GlenNicholls/solar_tracking_project/docs/pi_hat/pi_pinout.JPG

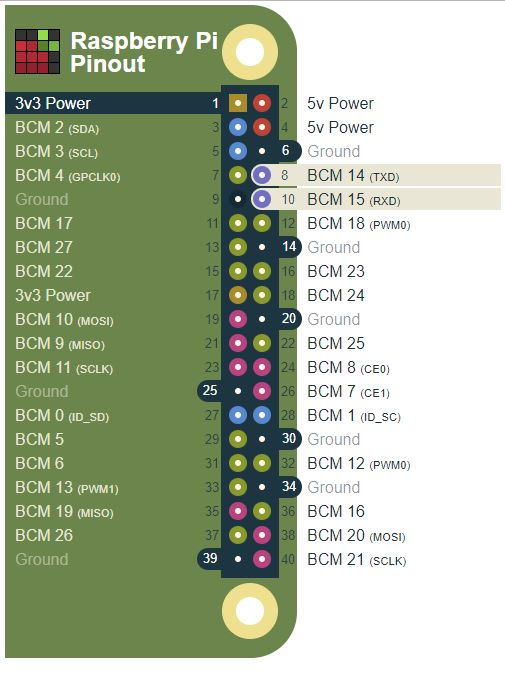
docs/pi_hat/pi_pinout.JPG
