GlenNicholls/solar_tracking_project/src/README.md

# TODO:
Update with descriptions of each package

* ACS712
* DS3231
* management_scripts
* MCP3008
* misc_dev
* motor_control
* open_loop_tracking
* shaft_encoder
* system_monitor
