GlenNicholls/solar_tracking_project/docs/pi_hat/GPIO_Pinout.xlsx

Component Pin | Description | Pi # | BCM # | Notes
Shaft Encoders
Az A | Azimuth A | 29 | 5 | lvl shifted
Az B | Azimuth B | 23 | 11 | lvl shifted
El A | Elevation A | 37 | 26 | lvl shifted
El B | Elevation B | 33 | 13 | lvl shifted
MCP3008 ADC
ADC 10 | CS | 19 | 10
ADC 11 | DIN | 38 | 20
ADC 12 | DOUT | 35 | 19
ADC 13 | CLK | 40 | 21
DS3231 RTC
RTC 7 | SDA | 3 | 2 | lvl shifted, DNP 3.3 lvl shift resistor
RTC 8 | SCL | 5 | 3 | lvl shifted, DNP 3.3 lvl shift resistor
ATTiny84 Microcontroller
AT 4 | RST_IN | 36 | 16 | lvl shifted, 5v from USB directly
AT 6 | PA7_PCINT7 | 22 | 25 | lvl shifted
AT 7 | MOSI | 18 | 24 | lvl shifted
AT 8 | MISO | 16 | 23 | lvl shifted
AT 9 | SCK | 32 | 12 | lvl shifted
AT 10 | PA3_DM | 24 | 8 | lvl shifted
AT 12 | PA1_FAULT | 26 | 7 | lvl shifted
L297 Motor Control
L297_1 | AZIMUTH_EN | 15 | 22 | enable for azimuth motor driver
L297_2 | ELEVATION_EN | 13 | 27 | enable for elevation motor driver
L297 | RESET_N | 31 | 6 | shared between both L297 driver chips
L297 | CLOCK_N | 21 | 9 | shared between both L297 driver chips
L297 | DIRECTION | 28 | 1 | shared between both L297 driver chips
Limit Switches
LIM_SW | 0 | 11 | 17
LIM_SW | 0 | 12 | 18
