GlenNicholls/solar_tracking_project/docs/sun_sensor/sun_sensor model.PNG

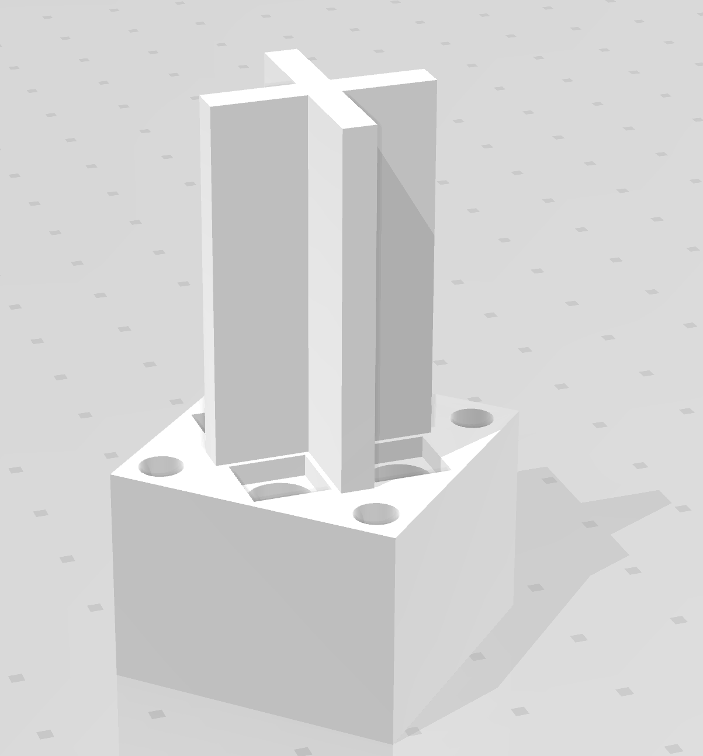
docs/sun_sensor/sun_sensor model.PNG
