GlenNicholls/solar_tracking_project/hardware/pi_hat/bom_2018_10_19T213238.xlsx

Index | Quantity | Part Number | Manufacturer Part Number | Description | Customer Reference | Available | Backorder | Unit Price | Extended Price USD
1 | 26 | 311-10.0KMCT-ND | RC0201FR-0710KL | RES SMD 10K OHM 1% 1/20W 0201 |  | 26 | 0 | 0.046 | 1.20
2 | 2 | 296-46095-1-ND | INA215AIDCKR | IC CURRENT MONITOR 1% SC70-6 |  | 2 | 0 | 1.5 | 3.00
3 | 2 | 1276-1013-1-ND | CL03A104KQ3NNNC | CAP CER 0.1UF 6.3V X5R 0201 |  | 2 | 0 | 0.1 | 0.20
4 | 13 | BSS138CT-ND | BSS138 | MOSFET N-CH 50V 220MA SOT-23 |  | 13 | 0 | 0.279 | 3.63
5 | 1 | 277-1238-ND | 1729034 | CONN TERM BLOCK 4POS 5MM PCB |  | 1 | 0 | 2.11 | 2.11
6 | 1 | 36-2998CT-ND | 2998TR | BATTERY RETAINER COIN 6.8MM SMD |  | 1 | 0 | 0.75 | 0.75
7 | 1 | P1.0NDCT-ND | ERJ-M1WTF1M0U | RES 0.001 OHM 1% 1W 2512 |  | 1 | 0 | 0.57 | 0.57
8 | 1 | CSRN2512FKR300CT-ND | CSRN2512FKR300 | RES 0.3 OHM 1% 2W 2512 |  | 1 | 0 | 0.73 | 0.73
