GlenNicholls/solar_tracking_project/docs/sun_sensor/final_v2.stl

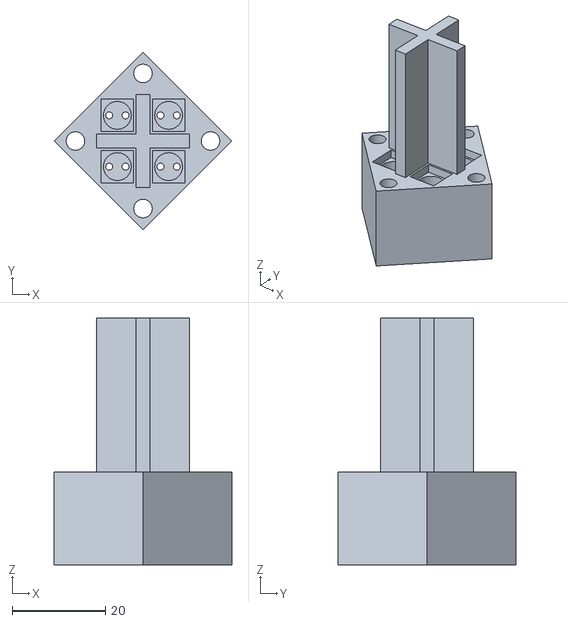
[picture p3: CAD file, 2018-12-11]
docs/sun_sensor/final_v2.stl
38.2 x 38.2 x 53.0
