GlenNicholls/solar_tracking_project/(list of files, cad)

Other CAD files:
docs/sun_sensor/final_v1.dwg
