GlenNicholls/solar_tracking_project/docs/changelog.txt

#REV, original part/connection, new part/connection, notes
