GlenNicholls/solar_tracking_project/(threads)

Thread 2 (2018-10-17):

Todo: WDT

bandtank, 2018-10-17:
https://github.com/GlenNicholls/solar_tracking_project/blob/bb61a96dae439378dc81f3529e3258df7cf112c5/misc_dev/attiny84a/src/ex_blinky_interrupts/ex_blinky_interrupts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

Setup and enable the WDT. Use a timer match/overflow interrupt/compare to reset the WDT. This is critical in case you get into a weird state.

Thread 4 (2018-10-17):

Multiple interrupts causing contention

bandtank, 2018-10-17:
https://github.com/GlenNicholls/solar_tracking_project/blob/89bd5b87050819dc284a78d5802128b977265ed5/misc_dev/attiny84a/src/power_circuit_ctrl/power_circuit_ctrl/mai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

How will multiple interrupts cause contention? This comment makes me think the right way to handle servicing the power control lines is to do it in a function outside of an interrupt. Setting flags and making a decision later will prevent contention issues if you don't have all the information in one ISR.

GlenNicholls, 2018-10-17:
That was an old comment that I don't think applies. I think the most complicated scenario is that the RTC alarm state interrupt is currently expected to change while the pi hold on interrupt is being serviced. I think this should change as it doesn't feel like the right way of doing it. As for contention, I've just been reading the value of the PORTA register to make sure it's being changed only when it needs to be.

bandtank, 2018-10-17:
We can talk through the logic to decide how to handle the actual setting and clearing of the bit. There are a number of ways to do it, most of which involve either an explicit or implicit mutex. Implicit mutexing can be accomplished by abstraction of error and/or boundary checking in functions.

Thread 5 (2018-10-17):

Unnecessary interrupt flag clearing

bandtank, 2018-10-17:
https://github.com/GlenNicholls/solar_tracking_project/blob/89bd5b87050819dc284a78d5802128b977265ed5/misc_dev/attiny84a/src/power_circuit_ctrl/power_circuit_ctrl/mai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

https://github.com/GlenNicholls/solar_tracking_project/blob/89bd5b87050819dc284a78d5802128b977265ed5/misc_dev/attiny84a/src/power_circuit_ctrl/power_circuit_ctrl/mai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

https://github.com/GlenNicholls/solar_tracking_project/blob/89bd5b87050819dc284a78d5802128b977265ed5/misc_dev/attiny84a/src/power_circuit_ctrl/power_circuit_ctrl/mai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

Being explicit is never bad, but this isn't necessary to do because the flags are cleared automatically when the ISR executes. Unless you have a specific reason to clear the flag at the end of the ISR, such as masking a new interrupt request for the same ISR while it's already being serviced, I would let it clear the flag on its own. There are rare, yet subtle, consequences to doing things like this that may not always be obvious up front.

GlenNicholls, 2018-10-18:
Just removed these for the time being. Will add later if we run into a situation where we need it.

Closed 2018-10-18.

Thread 6 (2018-10-17):

Software debounce

bandtank, 2018-10-17:
https://github.com/GlenNicholls/solar_tracking_project/blob/89bd5b87050819dc284a78d5802128b977265ed5/misc_dev/attiny84a/src/power_circuit_ctrl/power_circuit_ctrl/mai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

Implementing a software debounce using a timer will be relatively simple and usually quite robust. I'm guessing you didn't literally mean sleep, but, just to be sure, don't use sleep. The ISR will sit there twiddling it's thumbs which is bad news. ISRs need to get in and get out ASAP.

GlenNicholls, 2018-10-18:
So when using a timer, I assume it should just be started in the ISR, then the processor goes back to sleep and wakes up again when the timer raises a software interrupt?

GlenNicholls, 2018-10-18:
Oh nevermind, I see there is a timer interrupt vector.

bandtank, 2018-10-18:
You can start and stop timers wherever you want. Timers may be one of, if not the most, useful peripherals. It would behoove you to study the timer chapters in depth because the counting patterns, waveforms, match generation interrupts, and tons of other things have practically unlimited applications. I once made a state machine that used four timers, each with four compare match interrupts, to drive an external DAC and then the input capture source of a fifth timer to get nanosecond precision on a timing pulse. I've seen much crazier things from other designers as well.

Tiny's don't have a ton of features, but the timers are still powerful. Once you get a handle on things, come back to timers to keep the system asleep as long as possible in as many situations as possible. You can double up on compare match interrupts for multiple high-level functions by keeping track of rollovers and things like that in globals or static variables.

Thread 7 (2018-10-17):

Readability and maintainability enhancements

bandtank, 2018-10-17:
https://github.com/GlenNicholls/solar_tracking_project/blob/89bd5b87050819dc284a78d5802128b977265ed5/misc_dev/attiny84a/src/power_circuit_ctrl/power_circuit_ctrl/mai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

In general, doing things like that can be prone to bugs later. It's also quite difficult to change pin assignments if you decide to make layout modifications. Do something like this:

    #define POWER_ON_PIN  PA0
    #define POWER_ON_PORT PORTA
    #define TURN_POWER_ON  SET_BIT(POWER_ON_PORT, POWER_ON_PIN)
    #define TURN_POWER_OFF CLR_BIT(POWER_ON_PORT, POWER_ON_PIN)

That is much, _much_ easier to maintain and it's also a lot more clear while reading the code what is happening. It also protects against logic inversions, e.g. if the power pin is active low instead of active high. Turning it on is very clear whereas literally setting or clearing a bit may not be.

GlenNicholls, 2018-10-18:
Is it best practice to place all of these in a header file?

bandtank, 2018-10-18:
That’s a bit of a religious question depending on who you ask. In general, yes, this type of thing should be in a header file because the code shouldn’t have any idea about the physical manifestation of the algorithm. Turn the power on means turn the power on regardless of how that translates into hardware. It’s not always that concise obviously, but abstraction is your friend especially when it comes to hardware interfaces.

Typically, I create header files with the following things from top to bottom:
* include statements
* hardware specific preprocessor definitions
* macros like LED0_ON, etc.
* function prototypes

In more complex projects, I will often put hardware specific definitions in a separate file to keep things organized and obvious. It depends on a lot of things, so there’s no right answer; be consistent and clear regardless.

While I’m thinking about it, embedded applications have to be smart about using strings more than you may currently realize. When you printf a fixed string, for example, it stores the string on the stack or heap depending on the situation, but you can’t afford to to support either option.

The flash memory is in a different address space depending on the architecture and accessing it from an instruction may or may not be possible. If it is possible like in an Atmel microcontroller, you can store strings there at the cost of significantly increased access time. On small microcontrollers, avoid this entirely by not using strings at all. When I say strings, I mean `char *` just to be clear.

In terms of memory conservation, globals and general purpose registers can be quite useful as long as you understand the volatile keyword and all that it implies. People get their parties in a bunch about globals on any platform, but they’re fine even in high level languages as long as you use them properly. Anyway, embedded applications are different due to memory constraints, so the paradigm isn’t as taboo.

Thread 12 (2018-10-21):

Put this in a package with sunrise/sunset similar to other packages

GlenNicholls, 2018-10-21:
https://github.com/GlenNicholls/solar_tracking_project/blob/c96660d3944b09754b287629c967a6d3fd50009d/src/main.py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

GlenNicholls, 2018-10-25:
Have new issue that captures this and a couple other things better...

Closed 2018-10-25.

Thread 15 (2018-10-21):

Last step should be making sure we can actually shutdown

GlenNicholls, 2018-10-21:
https://github.com/GlenNicholls/solar_tracking_project/blob/c96660d3944b09754b287629c967a6d3fd50009d/src/main.py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

We don't want to stomp on user in development mode noted by uC pin. There should be a routine here that doesn't set the next alarm until the user is done. Might need some smarts as well to see if we missed the next wakeup period as we're screwed if we right an alarm to the RTC and the time has passed already.

Maybe this might be bug at some point, but we'll burn that bridge when it falls.

GlenNicholls, 2018-11-08:
The following code needs to be tested

https://github.com/GlenNicholls/solar_tracking_project/blob/abf6216847b46e178da2fa546de0279f9cbe5690/src/main.py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

Thread 18 (2018-10-21):

Consider using built-in macros for AVR register access

bandtank, 2018-10-21:
https://www.nongnu.org/avr-libc/user-manual/group__avr__sfr.html

```
#define _BV(bit)   (1 << (bit))
#define bit_is_set(sfr, bit)   (_SFR_BYTE(sfr) & _BV(bit))
#define bit_is_clear(sfr, bit)   (!(_SFR_BYTE(sfr) & _BV(bit)))
#define loop_until_bit_is_set(sfr, bit)   do { } while (bit_is_clear(sfr, bit))
#define loop_until_bit_is_clear(sfr, bit)   do { } while (bit_is_set(sfr, bit))
```

It could simplify some of the defines, but it's fine either way.

GlenNicholls, 2018-10-21:
interesting, I'll check this out! I knew there was something like this, but the examples I saw online looked like they were for Arduino IDE, so I wasn't sure where those were coming from.

bandtank, 2018-10-21:
On that note, check the [library reference](https://www.nongnu.org/avr-libc/user-manual/modules.html). There's a ton of stuff you might need, e.g. [Power Reduction Management](https://www.nongnu.org/avr-libc/user-manual/group__avr__power.html). There's value in learning how to do these things manually, but using library functions doesn't completely mask the requirement to understand what you're doing with the hardware.

GlenNicholls, 2018-10-22:
If I have to learn how to use a library, I quit.

bandtank, 2018-10-22:
Let’s go collect sand so we can make our own silicon wafers. I think we should start all the way at the beginning to make sure we do as much non-innovative work as possible.

GlenNicholls, 2018-10-22:
Ooo, that's a good idea. Another thing I thought would be a good idea for system configuration, we should use a CSV with sub-delimeters to load our settings

GlenNicholls, 2018-10-25:
Used many of these noted in the macro libraries.

Closed 2018-10-25.

Thread 19 (2018-10-24):

Define clocking for uC in Makefile

GlenNicholls, 2018-10-24:
https://github.com/GlenNicholls/solar_tracking_project/blob/5e9910b60f4fe3ec53cd6ad5541e268fe9e95c2b/misc_dev/attiny84a/src/pi_hat_ctrl/Makefile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

Best to define clocking here and pass it down to the code... Spent a long time trying to talk to this device again after reducing the clock to 125kHz and the default programming speed couldn't identify the device or recover fuses.

-i is the spi clock delay, so this should also be parameterized according to system clock. Should be ~4 times slower than the uC system clock

bandtank, 2018-10-24:
You might want to go slower than 4x. That should be fine, but slower won't hurt anything.

Is the delay in microseconds? You should probably put a comment specifying the unit and how it is used to derive the clock frequency. It will also be very helpful down the road if you put a comment in the makefile about how to program the microcontroller using the file. It's fresh in your mind now, but it won't be in six months (hypothetically).

GlenNicholls, 2018-10-24:
Yes, it is in us. I'll put a comment in there to denote both of those things. What is a reasonable frequency to run at? I am currently using 125kHz, but I feel like I could divide the clock all the way and be fine, I'm just not sure if there is going to be something that will bite me later.

bandtank, 2018-10-24:
Which clock do you intend to use as the system clock and at which frequency? As far as I know, this system doesn’t have much processing to do and there are relatively lax deadlines involved; assuming that’s true, I think the low power, internal 128 KHz oscillator would be sufficient. You may even be able to use a prescaler of 8 to provide a system clock of 16 KHz if the system can tolerate that setting.

In the first case, I would use a 25 KHz programming frequency. In the second case, 4 KHz would be appropriate. 25% is a good rule of thumb and should always work, but there’s no reason to rush it since this will be done very infrequently, if ever, after it works reliably.

Debug is different. For now, go faster so you aren’t waiting forever to iterate.

GlenNicholls, 2018-10-29:
documenting your email suggestion so I don't forget to do this:

    make -DF_CPU=125000

somewhere in the code:

    #ifndef F_CPU
    #error You must define F_CPU
    #else
     #if F_CPU == 125000
       OCRA1 = 0x12;
     #elif F_CPU == 250000
       OCRA1 = 0x34;
     #else
       #error Unsupported value for F_CPU
     #endif
    #endif

GlenNicholls, 2018-10-30:
From suggestion, this has been tested and works well. The worst case programming SCK has been accounted for to be 4x slower than the lowest device frequency:

https://github.com/GlenNicholls/solar_tracking_project/blob/64621bb102d3db1e32168b8d61db00277a282412/misc_dev/attiny84a/src/pi_hat_ctrl/Makefile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

The below is used to configure each timer along with clocking:

https://github.com/GlenNicholls/solar_tracking_project/blob/64621bb102d3db1e32168b8d61db00277a282412/misc_dev/attiny84a/src/pi_hat_ctrl/attiny84.h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

Closed 2018-10-30.

Thread 20 (2018-10-25):

[PCB] Programming uC will cut power to pi

GlenNicholls, 2018-10-25:
When the pi starts to program eeprom by pulling reset low, all the pins enter their default state causing the load switch to turn off. This will mean the pi will be shutoff as soon as it starts to program. If this is just a floating pin, we can add an external pullup. If not, I think the best solution is to add a jumper for programming mode where the load switch is pulled up and the pi doesn't lose power when programming. Will investigate this further this weekend.

GlenNicholls, 2018-10-25:
If there is a way to make pins use pullups during reset, I will do that instead.

bandtank, 2018-10-25:
No. You will have to use an external component to guarantee the state of a pin that isn't actively driven by the microcontroller. During reset, the pins configured as floating inputs and, as far as I know, there's no way to alter that behavior.

GlenNicholls, 2018-10-25:
Darn, wish I thought of this before we did the PCB. I'll just blue-wire something for the time being and we'll update the schematic to use a jumper.

GlenNicholls, 2018-10-25:
So open the issue against the layout and reference in the notes of the schematic?

GlenNicholls, 2018-10-25:
Also, I just tested this and it looks like the load switch isn't affected. The output remains high for anything other than a logic zero. I'm not sure if it's worth looking into further in this case, but I'm open to suggestions. I guess if the load switch ever gets changed this might be an issue, but as of now, it looks like it is not affected during ICSP.

GlenNicholls, 2018-10-25:
So the datasheet says that it cannot be left floating and doesn't say anything about an internal pullup. I think putting an external pullup on that line makes the most sense unless you would prefer we use a jumper. I'm going to use a pullup for our PCB so we don't have to re-spin it, but we can put a jumper in the schematic/layout we give you.

bandtank, 2018-10-25:
I presumed it would not have an internal pullup, so you'll need to add one. This is a bug waiting to happen.

There's nothing wrong with cutting traces, adding components, or using jumpers to modify the board. It's uncommon to get it right on the first try and correct behavior is far more important than a pristine layout.

GlenNicholls, 2018-10-26:
I see your point. Closed testing at home at room temperature with no switching is fine. I suspect that higher temperatures and noise will cause this to fail.

bandtank, 2018-10-26:
Yeah, that's pretty much the idea. Temperature, noise, stray capacitance, solar activity, and many other things could cause non-deterministic behavior.

GlenNicholls, 2018-10-31:
@graemeDnf, feel free to close this when the pcb reflects ISSUE#20 in the schematic

Closed 2018-11-03.

Thread 21 (2018-10-25):

How accurate is this?

GlenNicholls, 2018-10-25:
https://github.com/GlenNicholls/solar_tracking_project/blob/5e9910b60f4fe3ec53cd6ad5541e268fe9e95c2b/src/main.py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

Need to figure out how accurate this is. If this is pulling location from nearest ISP whatever it's called, this could be pretty far away from customers location.

I messed with something similar (not with python) a long time ago and it was yielding lat/long of Comcast in Colorado Springs about 5 miles from my house. I don't know how this error would affect us if this is the case, but it's worth looking in to. If this is the case and it is too much error, we could have something in the high-level interface for the user to enter their specific coordinates.

bandtank, 2018-10-25:
There's nothing wrong with requiring input from the user to setup a system like this. Getting the location automatically is a nice feature, but I wouldn't bother with it. It's too small of a feature and it will cost too much time to validate the process. Ask for lat/long and call it a day.

GlenNicholls, 2018-11-19:
Just checked this and it is indeed very far off due to info above. A better solution might be http://www.indjango.com/google-api-to-get-lat-long-data/ but this is not a priority at all. I will be hardcoding for now unless we have time to do this

Thread 23 (2018-10-29):

[PCB] Switching noise from alarm condition causes uC to briefly enter reset due to TTL threshold

GlenNicholls, 2018-10-29:
RESET_N pin of uC has been having issues when the alarm pin goes low causing device to briefly enter reset which causes glitching on power control pin (led to false positive during testing). Need to add 10K pullup to fix the metastable condition.

Probing without the pullup, the voltage is 1.54V (3.3V Vcc), but drops to 1.48V during an alarm condition before slowly coming back up to 1.54V where it comes out of reset. Probing the RESET_N pin caused this brief reset not to occur, so I think that capacitance caused the device not to drop below the TTL threshold.

bandtank, 2018-10-29:
The reset pin definitely needs to be pulled high. You should also add a
capacitor to ground.

On Sun, Oct 28, 2018 at 7:04 PM GlenNicholls <notifications@github.com>
wrote:

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

GlenNicholls, 2018-10-29:
We have this going through a level shifter, should the LPF be on the high or low side? Does it matter?

bandtank, 2018-10-29:
Is the schematic updated? If so, where should I be looking?

GlenNicholls, 2018-10-31:
@graemeDnf , feel free to close this when the PCB has the pullup noted by ISSUE#23 in the schematic.

Closed 2018-11-01.

Thread 24 (2018-10-29):

Missed voltage divider resistors on PCB

GlenNicholls, 2018-10-29:
ISSUE#24 is noted in PDF for the missing resistors from the PCB.

graemeDnf, 2018-10-30:
Added resistor dividers for voltage measurement

Closed 2018-10-30.

Thread 25 (2018-10-30):

[UCSW] Sleep mode for attiny84a does not work per noted code

GlenNicholls, 2018-10-30:
After referencing a few sources in addition to the following, the below sleep code still does come out of sleep from interrupts:

[https://www.electronicsweekly.com/blogs/engineer-in-wonderland/atduino-go-sleep-attiny-2017-08/](url)

https://github.com/GlenNicholls/solar_tracking_project/blob/dc396e505067940ffb68f793bffcb7f520a1185a/misc_dev/attiny84a/src/pi_hat_ctrl/main.c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

bandtank, 2018-10-30:
Have you tried it without any of the more complex logic? What happens if you simply go to sleep in main using `sleep_cpu()`? Have you ever successfully woken the uc from sleep in any configuration?

GlenNicholls, 2018-10-30:
Sorry for the confusion, I just tested that with just the IDLE sleep mode and the device successfully comes out of that. When I test with power down, I'm unable to get it to come out of sleep with an alarm condition on the RTC which will turn power on based on INT0

bandtank, 2018-10-30:
Make sure you are following the constraints in this paragraph:

```
7.1.3 Power-Down Mode
When the SM[1:0] bits are written to 10, the SLEEP instruction makes the MCU enter Powerdown
mode. In this mode, the Oscillator is stopped, while the external interrupts, and the Watchdog
continue operating (if enabled). Only an External Reset, a Watchdog Reset, a Brown-out
Reset, an external level interrupt on INT0, or a pin change interrupt can wake up the MCU. This
sleep mode halts all generated clocks, allowing operation of asynchronous modules only.
```

GlenNicholls, 2018-10-30:
So I was trying to debug why it wasn't working so I continue to re-enable the interrupts as I wasn't sure if there was something that wasn't stated explicitly in the datasheet (the ads on the site made it impossible to see what that person's reasoning was). After removing that code, I see the same behavior.

Once I added a 50ms delay, I was able to get the push button to get the device out of power down, so after removing the delay, it looked like it would sometimes catch the button interrupt, and sometimes it wouldn't (due to the 8-bit timer clock going down beforehand). However, the `INT0` interrupt was never recognized with this delay. After I used a pin change interrupt, `PCINT10` on `PCINT1_vect`, I am able to capture all interrupts, so it does look like the `cli();` caused the processor to catch the interrupt, but not set it in time before disabling interrupts.

Looks like the issue was with there not being enough delay before `cli();`, but I think that at 32kHz, the `INT0` level is not held long enough with the 50ms delay.

I think this is resolved, but this brings up a question again that I asked you a while ago about putting numerous pin change interrupts on one INT vector. Will this have any implications moving forward that I am not aware of?

GlenNicholls, 2018-10-31:
This has been tested and will now be closed.

Closed 2018-10-31.

Thread 26 (2018-10-30):

Will cause py.test to hang

GlenNicholls, 2018-10-30:
With a `while true:`, this will cause test to hang when py.test constructs the test fixture. Consider referencing `DS3231/test` for creating a test function/class and change to `dev_*.py` for development checks to run manually. This should have a test, but using the filename `test_*.py`, py.test will add this to the sources when it does an os walk.

https://github.com/GlenNicholls/solar_tracking_project/blob/54261cbb0eadff70b82e4030e92d69b88a0ffb34/src/shaft_encoder/test/test_class_counting.py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

GlenNicholls, 2018-11-08:
name has been changed and test routine needs to be added

Thread 27 (2018-10-30):

[PCB] Update silkscreen and ensure component numbers match schematic

GlenNicholls, 2018-10-30:
Silkscreen needs to be updated and all component numbers should match schematic. For the headers, make sure that the silkscreen states what each pin is for.

For each component, make sure the component number is not covered by the part and readable with surrounding traces. Also ensure no vias or surrounding pads will cut off the number. For some of the passive components, the pads cut off part or all of the number/letter.

For the pi header, note with slikscreen which pin is pin1, I assume it's the square one, but this should be done to be safe. With this said, dots for ICs in the component outline should be used instead of the line that is hard to see on the PCB.

For all diodes and LEDs, there should be an arrow to note the continuity. I will add comments as I find other stuff.

GlenNicholls, 2018-11-08:
@graemeDnf I know I texted you about this, but you said this has been updated?

Closed 2018-11-19.

Thread 29 (2018-10-30):

[PCB] Add ground plane to reduce noise and interference

GlenNicholls, 2018-10-30:
A ground plane should be on the list of todos to be completed eventually. Probably best to have a digital ground plane as well, but we can always use some 1-10ohm resistor for the ADC with just an analog ground plane.

Thread 30 (2018-10-30):

[PCB] Break out motor control pins to header

GlenNicholls, 2018-10-30:
Motor control pins should be broken out to external header similar to the shaft encoders so we don't need to use extra long headers on the Pi to use these.

GlenNicholls, 2018-11-08:
@graemeDnf What is the status of this?

Thread 31 (2018-10-30):

[PCB] Add test points

GlenNicholls, 2018-10-30:
Add test points for important nets. I will be adding comments for where some of these should go for the stuff that I did

GlenNicholls, 2018-11-04:
* pin 3, 6 of DS3231
* pin 3, 4, 6-10, 12, 13 of attiny
* +5v/Gnd of USB
* pin 5||8 of tps22958
* pin 9-16 of MCP3008

Closed 2018-11-19.

Thread 32 (2018-10-30):

[PCB] Add motor control PCB and documentation to hardware/

GlenNicholls, 2018-10-30:
The motor control PCB layout, schematic, and documentation need to be added to the project soon.

Thread 33 (2018-10-30):

[PCB] fix missing connection on attiny devmode level shifter

graemeDnf, 2018-10-30:
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
Connection was deleted between low side of level shifter and 3.3v rail

graemeDnf, 2018-10-30:
PCB file updated and pushed, awaiting confirmation of bluewire fix on existing board

GlenNicholls, 2018-10-30:
yeah that's gonna be a bit if you want to CALM DOWN

GlenNicholls, 2018-10-30:
Just to confirm, the highlighted via connects to the left pad of the resistor right above it?

graemeDnf, 2018-10-30:
Correct. This is the bottom copper though, so the directions will be flipped when you look at the bottom side of the actual board. Also, it will probably be easiest to solder that resistor pad to the left pad of one of the neighboring resistors (same net) rather than the via

Thread 34 (2018-10-30):

[SCH] R33/35 DNP was mistakenly swapped with R34/36

GlenNicholls, 2018-10-30:
on the pi-hat schematic, R33/35 should not be DNP, but R34/36 should be instead. R34/36 resistors are on the low side on the pi and should be DNP so we don't have to de-solder resistors on SDA/SCL on the pi.

Closed 2018-11-29.

Thread 35 (2018-10-30):

[SCH] R23 states 250mOhm, but BOM has 300mOhm

GlenNicholls, 2018-10-30:
In the schematic, R23 for the current sensor is shown to be 250mOhm, but the BOM has a 300mOhm on order. Probably not a big deal, but should be accounted for in calculations and should also be adjusted to whichever is the correct value.

graemeDnf, 2018-10-30:
300m was significantly cheaper in the 2512 package, so I put that on the BOM. I ensured it would work with the new value, so I'll update it when I get a chance

GlenNicholls, 2018-10-30:
okay cool, I just wanted to make sure.

Closed 2018-11-19.

Thread 36 (2018-10-30):

[PCB] S2 should be on edge of board

GlenNicholls, 2018-10-30:
S2 is a right angle push button and should be on the edge of the PCB

GlenNicholls, 2018-11-02:
vertical push button can work as well, but doesn't matter a whole lot

GlenNicholls, 2018-11-08:
@graemeDnf What is the status of this or adding vertical push button?

Thread 37 (2018-10-30):

[PCB] Switch connection error (Graeme messed up, mk2)

graemeDnf, 2018-10-30:
attiny pin wired to incorrect side of pushbutton switch

GlenNicholls, 2018-10-30:
Can you be more specific with a pic? I'm not seeing the issue unless it's the via, but I don't know where that goes.

GlenNicholls, 2018-10-31:
Also, remove R37, R6, and C5 from the PCB as these aren't needed since debouncing in software works more than well enough. Just let me know where I should connect the wires for the button instead and I'll test it on Thursday.

Closed 2018-11-01.

Thread 38 (2018-10-31):

[PCB] LEDs have wrong pad size: 1206 instead of 0603

GlenNicholls, 2018-10-31:
The pad size of the LEDs looks like 1206, but should be 0603

Closed 2018-11-01.

Thread 46 (2018-10-31):

[PISW] Add Makefile or automatic system configuration

GlenNicholls, 2018-10-31:
Use a Makefile or something similar to automatically configure the system using the steps in the README. In addition to the README steps, this should also run the main.py application and add this to the boot sequence so it runs automatically on power up.

GlenNicholls, 2019-01-30:
Found this which will make this fairly easy:

https://www.raspberrypi.org/forums/viewtopic.php?f=63&t=226609

Thread 47 (2018-10-31):

[SCH,PCB] Add changelog.txt

GlenNicholls, 2018-10-31:
Add changelog to keep track of changes to PCB and schematic

GlenNicholls, 2018-11-01:
Closing per 162d92a and 062ac8

Closed 2018-11-01.

Thread 49 (2018-10-31):

[PISW] Change ACS712 package to support INA215

GlenNicholls, 2018-10-31:
This class should be abstracted further since we have a different current sensor. The eqns are probably in the datasheet. As for other devices using the MCP3008 ADC, we need to pull that out of this class and possibly pass in an ADC instantiation instead.

GlenNicholls, 2018-11-08:
Done per b07c53d

Closed 2018-11-08.

Thread 50 (2018-11-01):

[PCB] Incorrect reference connection on curr. sense amps

graemeDnf, 2018-11-01:
ref (pin 1) should be connected to ground rather than +3.3v on both shunt resistor amplifiers

GlenNicholls, 2018-11-01:
I have added a changelog, so just fill this out as stuff gets updated in the schematic/pcb

Closed 2018-11-01.

Thread 51 (2018-11-01):

[PCB] Push button wiring error

graemeDnf, 2018-11-01:
attiny pin is connected to gorund, rather than floating voltage pin of the pb switch

Closed 2018-11-19.

Thread 52 (2018-11-01):

[PCB] Add issue numbers to track these bugs/enhancements

GlenNicholls, 2018-11-01:
Can you add the issue numbers for each of these?

https://github.com/GlenNicholls/solar_tracking_project/blob/a8d980774f226571aa13784ffcb01d792a122243/hardware/pi_hat/changelog.txt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

Thread 53 (2018-11-02):

[PISW] Figure out how to enable debug log level for specific sub-module

GlenNicholls, 2018-11-02:
This would be a nice feature where the user could select from the high-level interface which sub-module to spit out to file/database without having to spew a ridiculous amount of unwanted information from other modules.

https://github.com/GlenNicholls/solar_tracking_project/blob/ff0ca15a51329c8713c68a152ccea38717c1dcd2/src/main.py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

GlenNicholls, 2018-11-09:
Researched this a bit and it isn't too bad:

https://stackoverflow.com/questions/7234262/how-to-implement-different-levels-for-specific-modules-in-python

Currently, I have something like the following:

    class some_class(object):
        def __init__( logger='main_logger')
            self.logger = logging.getLogger(logger + '.' + __name__)

This will yield a call that shows `main_logger.<class dir>.some_class`. However, this method does not lend itself to easily vary the debug level for this specific module based on the above link. To adjust this, we can hardcode the names in the top level with the following example code

>>>main.py:

    logger_name = 'main_app'
    sub_1_name = 'sub_module'

    inst = some_class(logger_name, sub_1_name)

This will yield the following output name somewhere in the log `main_app.sub_module`, then we can easily use the above link to have a higher level interface select to turn on debug level logging for this module. The class should now look like this:

    class some_class(object):
        def __init__( logger='main_logger', module_name='module_name')
            self.logger = logging.getLogger(logger + '.' + module_name)

This example can be seen in the `power_measurement.py` package, I will also start adding this compatability.

GlenNicholls, 2018-11-12:
closed per 29b9c7f

Closed 2018-11-12.

Thread 54 (2018-11-02):

[UCSW] Add manual clearing of FAULT

GlenNicholls, 2018-11-02:
Currently, the device cannot clear fault condition unless re-flashed. Will be adding a manual override for this using the push button where the SW will set a flag and start the big timer and if the button is still held, it will clear the fault flag.

I can't immediately think of a situation where this is needed, but might be nice to have if the bug has been fixed on the pi side without having to re-flash software.

GlenNicholls, 2018-11-12:
closed per 06944a0

Closed 2018-11-12.

Thread 55 (2018-11-02):

[PISW] Pass objects by reference to keep main clean

GlenNicholls, 2018-11-02:
Specifically for power measurements and the shaft encoder interrupts, instantiate object in main and pass to sub-classes by reference.

Closed 2018-11-13.

Thread 56 (2018-11-02):

[PCB] remove pcb files that are out of date

GlenNicholls, 2018-11-02:
Not sure if that file is needed, but I don't want to cause issues by removing it

Closed 2018-11-29.

Thread 57 (2018-11-02):

[PCB] USB micro B female not close enough to edge of board and needs revision

GlenNicholls, 2018-11-02:
The usb connector needs to be closer to the edge of the PCB. The silkscreen box edge for the USB connector should be touching the edge of the PCB.

Also, we need something with pins that go down into the PCB as the force to plug it in will rip the connector off the board.

graemeDnf, 2018-11-03:
Moved header to the edge of the board. Did you solder the larger pads on the header to the board as well? it seems like the pin breakout boards still have a usb header mounted on the surface in the same way, so I'm not sure if using something like that will make a difference

GlenNicholls, 2018-11-03:
@graemeDnf I thought I did, I watched the solder flow under the scope, but it doesn't look like it made a good connection since I don't have an oven or a heat gun... I guess I wasn't careful enough. The two smaller pads were definitely connected, but the two big ones looked pretty clean after the break. With that said, having something with pins that go into the board will give more support for external forces. I looked around online, and this seems to be a really common issue with the type of connector that we chose unless you're conscious about plugging USB in.

Considering we're pulling straight from the charge controller USB, we don't have many other options, but I think it will work fine if we can solder a couple pins in a via.

If you look at the pi, it has something like this and seems to work pretty well. Now that I think about it, we should definitely change to a button that has a vertical push as well so we don't run into this again with that.

GlenNicholls, 2018-11-04:
We need something similar to this:

https://www.mouser.com/ProductDetail/Hirose-Connector/ZX62D-B-5PA830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

GlenNicholls, 2018-11-04:
Also, if it is possible, try to extend the 5 pin pads for the power/data lines to make soldering the device easier

graemeDnf, 2018-11-04:
Ended up using this https://www.digikey.com/product-detail/en/amphenol-fci/10118194-0001LF/609-4618-1-ND/2785382. I tried making a PCB symbol with extended pads, but couldn't get designspark to play nice with the necessary spacing tolerance, so I went with the amphenol connector because it had a pcb footprint available

Closed 2018-11-04.

Thread 58 (2018-11-04):

[PCB] Break out power to header

GlenNicholls, 2018-11-04:
Put in a debug power header somewhere so I can connect a power supply if needed.

GlenNicholls, 2018-11-08:
Done per 5f4a625

Closed 2018-11-08.

Thread 59 (2018-11-04):

[PCB] Remove diode D4

GlenNicholls, 2018-11-04:
This needs to be removed and replaced with a wire

graemeDnf, 2018-11-04:
done

Closed 2018-11-04.

Thread 62 (2018-11-05):

[PISW] Make flash gui

GlenNicholls, 2018-11-05:
Tony, can you make us a flash gui and couple it as tight as possible to our application code?

bandtank, 2018-11-05:
Holy shit. I saw 'Make flash gui' on my phone's notification and I almost had a heart attack. Funny, yet cruel.

Closing with prejudice.

GlenNicholls, 2018-11-05:
good, I had a feeling this would induce a similar response.

Closed 2018-11-05.

Thread 63 (2018-11-06):

[PISW] Abstract pin definitions to top level

GlenNicholls, 2018-11-06:
This should be abstracted and defined in the top level to make debugging easier if GPIO selections ever change.

https://github.com/GlenNicholls/solar_tracking_project/blob/5f4a6251b6567d04bb99f3fe21d7501a97bfdef9/src/motor_control/stepper_motor.py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

GlenNicholls, 2018-11-13:
done

Closed 2018-11-13.

Thread 64 (2018-11-06):

[PISW] Avoid using python keywords for variables

GlenNicholls, 2018-11-06:
https://github.com/GlenNicholls/solar_tracking_project/blob/5f4a6251b6567d04bb99f3fe21d7501a97bfdef9/src/motor_control/stepper_motor.py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

Thread 66 (2018-11-07):

[PCB] Consider INA219 if we can't get INA215 working properly

GlenNicholls, 2018-11-07:
Not too sure why the INA215 is not working properly, but my suspicion is that we got the wrong part. Nothing in the PCB looks off and I have bluewired the correct GND reference and still see the same behavior. With the way the INA is placed, I am seeing Vout reading 3.2V on both sensors, so either our calculation for the shunt resistor is wrong, or the ongoing issues with the chip markings indicate that the part sent is not correct.

I have found this: https://www.adafruit.com/product/904

Let's wait to look into this further until the re-spin gets here. I will be looking into the current sensors further to see if I can figure out what is going on with this thing.

GlenNicholls, 2018-11-09:
While testing each ADC channel, this is what I see:

    | ADC Ch 0 | ADC Ch 1 | ADC Ch 2 | ADC Ch 3 | ADC Ch 4 | ADC Ch 5 | ADC Ch 6 | ADC Ch 7 |
    +----------+----------+----------+----------+----------+----------+----------+----------+
    |   927    |   925    |    57    |    14    |    7     |    6     |    4     |    0     |
    +----------+----------+----------+----------+----------+----------+----------+----------+
    |   927    |   925    |    32    |    5     |    1     |    2     |    8     |    10    |
    +----------+----------+----------+----------+----------+----------+----------+----------+
    |   926    |   925    |    23    |    8     |    7     |    5     |    0     |    1     |
    +----------+----------+----------+----------+----------+----------+----------+----------+
    |   926    |   925    |    26    |    3     |    2     |    3     |    10    |    9     |
    +----------+----------+----------+----------+----------+----------+----------+----------+

First two channels are the current sensor outputs where maximum is 1024. I am seeing identical results when I probe these channels. I do not think that we have this connected wrong, but I think our selections for the Rshunt is not correct. I haven't had much luck finding anything specific to the INA, but per the white paper I read, the value according to ON is `I_sens = (Vout/Gain)/Rshunt`

https://www.allaboutcircuits.com/industry-white-papers/fundamentals-of-current-sense-amplifiers/pdfdownload/

With this equation, I am not surprised that channel 0 is over ranging (3.3v/75/0.3ohm=`0.1467A`). Channel 1 is curious to me, though, since I have the resistors grounded and see 3.23V output when I shouldn't (3.3v/75/0.001ohm=`44A`)

The TI website says that I should see ~15% error in the low current range for the 1mohm sensor, but this is much greater than that.... Let's test this thing on friday with a stable source and see if these change at all. If not, I have absolutely no clue how to debug any further. When I talked with digi-key, the rep made it sound like the pin assignments are supposed to be mirrored from the way the datasheet shows, so I am looking around for dev boards online to see if this is visible. If this is the case, this is going to be a PITA to fix.

GlenNicholls, 2018-11-17:
OMG TI!!!!!! Bout to post some chat from digi-key about their lack of updating ina21x documentation... BE PREPARED!!!!

GlenNicholls, 2018-11-17:
So, in short, the bar goes up. I have tried this with no success. I will try again with a stable current source on Sunday. I will be re-orienting the part, so if this doesn't work, I will try a new part. If it still doesn't work, I am throwing in the towel.

_**Info: Thank you for choosing to chat with us.  An agent will be with you shortly.
Info: You are now chatting with Chris_ext_2813.
Chris_ext_2813: Welcome to Digi-Key Live-Help. How may I assist you?
Glen: Hello, I am working with the INA215 and am unable to get consistent results. I have reached out before due to the lack of markings on the device for determining where pin 1 is and still am unable to get ADC raw readings that make any sense
Glen: The device is not marked with a dot on the top or bottom indicating where pin 1 is, but instead marked with "|SME"
Chris_ext_2813: Really? There is supposed to be a pin 1 index area on the top of the chip. Let me see if I can find anything on it.
Glen: I talked with a Timothy in a previous chat, although I didn't save the chat. Anyways, can I forward you an email that has the pic of the device under the scope? And you are correct, there is no marking for pin 1. I purchased 8 of these devices on our first order and was unable to get it working. A colleague then ordered two more from a seperate batch, and they have identical markings and perform the exact same
Chris_ext_2813: Yes you can send photos to datacenter@digikey.com

Just put ATTN: Chris x2813 in the subject line.

The SME marking is correct so we just have to try to figure out why there is no pin 1 mark on it.
Glen: Okay, I have just sent the email. For reference, I have configured the layout for unidirectional current sensing per page 15 in http://www.ti.com/lit/ds/symlink/ina210.pdf
Glen: I have tried the device in the orientation I sent you as well as rotated 180degrees. I have verified our ADC works, and for the orientation in the email, I see 0 no matter what, and with the shift, the ADC is close to railing at 3.24V with a vref of 3.3V. For reference, I am using the INA213, not INA215, so I apologize for that
Glen: My interpretation per the datasheet's top view is that the pin 1 is where the white line is in the scope picture and incrementing in a standard counter-clockwise fashion...
Chris_ext_2813: Well that would be my thought as well, but all their documents seem to show they use a standard dot to mark pin 1 and I see no PCNs from TI about any marking change on it so it seems odd. I just now got your email. Let me take a look
Glen: No worries, I'm not frustrated or anything. I'm just confused since it is a pretty straight-forward design and I have not had issues like this in the past with current shunt amplifiers
Chris_ext_2813: So I would expect it to have a dot according to the spec sheet which it does not have. The SME mark is correct and the two hashes above and below the marking is the date code marking. Looking at it, I would expect pin 1 to be the lower left pin and then the pins go up counter clockwise. One would assume the line is specifying the pin 1 side which would make the lower left pin 1.
Glen: Is it possible for you to use the snipping tool to label how you believe the pins are on the device in the picture that I sent? I'm not sure I understand exactly
Chris_ext_2813: Ok. So I did find a post on Texas Instruments E2E forum where someone had the same issue on a different part number and TI did confirm that the end with the bar is the pin 1 end. So pin 1 would be the lower left corner in your picture.

Let me see what I can do to label the pins in your photo.
Chris_ext_2813: Ok. I just sent you an email with labels for the pins. We do not have much for software on our work computers, but I think it is fairly legible.
Glen: Alright, thank you. I'm just waiting on the email now. Are you able to send me the link to the E2E forums you were mentioning earlier?
Chris_ext_2813: I did not put it in the email and like I said, the post is on a different part, but it the same issue. Data sheet just shows a shaded area in the corner labeled "Pin 1 Index Area", but the part received just had a bar down one side.

http://e2e.ti.com/support/audio/f/6/t/46746?which-is-pin-1-on-TPA6101A2-
Glen: Interesting, thank you for that reference. One final question before I part: The picture that you just sent, that is with respect to the markings on the part, correct?
Chris_ext_2813: Well I really just went off the fact they state the bar indicates pin 1. Because of how the parts are pinned, pin 1 has to be in the lower left corner and then I just labeled them according to the pin out on the data sheet.

But in general, pin 1 would be in the lower left corner with the marking correctly oriented to read it. While that is almost always how they are pinned, I did not want to say it was definitively the same until I found something from TI to confirm it.
Glen: I see, so from the picture that I sent, you would also agree that I had it oriented correctly considering the white bar indicating pin 1 on the PCB?
Chris_ext_2813: Yes I would agree
Glen: I'm just having trouble determining your point of reference since the datasheet shows pin 1 in the upper right hand corner. Thank you for working with me through the confusing explanations of pin numbering (it's easy when manufacturers mark their parts :/)
Glen: upper left hand*
Chris_ext_2813: It does, but it also has the IC turned 90°. If you flipped the picture 90°, pin 1 would then be in the upper left like the drawing on page 5
Chris_ext_2813: But I feel confident those pins are labeled correctly in the photo I sent
Glen: yeah, page 5 is the reference I was using. Okay perfect, I think that is the confirmation that I needed. Is there a way to pass along a complaint to TI about not mentioning the bar in their datasheet? Their pictures showed a standard dot marking which is what I expected to see, so it was definitely a process trying to decode this
Chris_ext_2813: You will actually notice on the E2E link that the customer they dealt with then said the same thing and it does not look like they have done anything to correct it yet and that post was from 8 years ago.

I am guessing TI is just not very concerned about it as they have done nothing to correct it still. I can certainly pass it along though.
Glen: haha yep, I just saw that. Well, here's to hoping! I would definitely appreciate that and I have now learned my lesson! I think I have what I need, so thank you again for taking the time to work with me.
Chris_ext_2813: Happy to help you. I hope it works correctly for you now.
Glen: yeah, I now have other things to debug it looks like considering I tried that orientation. I will reach out to them directly if I can't figure out what is going on
Chris_ext_2813: That is certainly a good option. That e2e forum generally gets you answers in a fairly timely manner. Although I do not know if anyone monitors it on weekends so you may be waiting until next week.

But if you still have issues come next week you can try contacting us again. The product managers work the banker hours Mon-Fri so they would be here 8-5 central time. Someone during the day may be able to help as well.
Chris_ext_2813: Is there anything else I can do for you today Glen?
Glen: I don't think so, I think that covers it!
Chris_ext_2813: Ok. Well good luck Glen and have a great weekend!
Glen: Same to you Chris!
Chris_ext_2813: Thank you for choosing Digi-Key. Feel free to contact us at any time.**_

GlenNicholls, 2018-11-19:
officially changed this to bug now that it is definitely not something we're doing wrong. I will be contacting TI to figure out what is going on with their part and looking around for another manufacturer that hopefully has something in the same package/pins. There will be no more debugging unless TI's response shows that the required bluewiring is realistic with everything else on the board populated...

GlenNicholls, 2018-11-30:
Looks like the issue boils down to needing INA 213 REVISION B! Closing this now that we have the sensors working reliably.

GlenNicholls, 2018-12-05:
Forgot to post this before:

https://e2e.ti.com/support/amplifiers/f/14/p/637442/2351816?tisearch=e2e-sitesearch&keymatch=tida-00302

Closed 2018-11-30.

Thread 67 (2018-11-09):

[PISW] Divide by zero is possible in sun sensor logic

GlenNicholls, 2018-11-09:
Per the below code, a divide by zero is occurring. To fix this bug, I have added a check. However, this should be calculated a different way so that a divide by zero isn't possible.

https://github.com/GlenNicholls/solar_tracking_project/blob/6af2f535bf763df34f412e42b67108aaeb416f1e/src/sun_sensor/sun_sensor.py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

example output shows how common this is while these ADC pins are floating:

    | Avg Horizon [%]  | Avg Vertical [%] |
    +------------------+------------------+
    |  0.133333333333  |  0.571428571429  |
    2018-11-08 17:28:02,430 - main_logger.sun_sensor - WARNING - Divide by zero occuring. Returning zero
    +------------------+------------------+
    | -0.229102167183  |       1.0        |
    +------------------+------------------+
    |  0.233333333333  |  0.823529411765  |
    2018-11-08 17:28:02,830 - main_logger.sun_sensor - WARNING - Divide by zero occuring. Returning zero
    +------------------+------------------+
    | -0.346749226006  |  0.933333333333  |
    +------------------+------------------+
    |       -0.1       |  -1.33333333333  |
    2018-11-08 17:28:03,263 - main_logger.sun_sensor - WARNING - Divide by zero occuring. Returning zero

GlenNicholls, 2018-11-09:
For more info, this might be able to be calculated as `% = num1/num2 * 100` and use an if statement to always divide by the bigger number. Even when ADC pins aren't floating, it should be very very unlikely to see either number as 0.

GlenNicholls, 2018-11-19:
Finalized this by moving to using a raw adc difference and averaging over a number of samples. We are no longer using percent differences since there is no gain and it is just unneeded complexity

Closed 2018-11-19.

Thread 68 (2018-11-11):

[PISW] Consider using GPIO.BOARD for pin numbering

GlenNicholls, 2018-11-11:
Using BCM is fine, but this could change between revisions of the raspberry pi. To fix this, consider using GPIO.BOARD as this will use the board pin numbering that will always be the same from pi revisions. Not really important right now, but something to consider working through for everything including AVRDude and MCP3008 package.

https://github.com/GlenNicholls/solar_tracking_project/blob/ca2fcb39cc0256b9cda4ceb9b5df7ddbd9b800b5/runner/main.py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

Thread 69 (2018-11-16):

[PCB] Dev mode and FAULT pins of the attiny never go low due to level shifter

GlenNicholls, 2018-11-16:
due to the resistor on the high-side of the level shifter, both LED 1 & 5 do not turn off as there is a pullup on this net. After probing the low-side, these both always read 3.3V and the high-side reads 2.75V when the pin is driven low. Is it valid to remove these two resistors??

GlenNicholls, 2018-11-16:
Another weird thing I notice is when I press and hold the button, both LEDs mentioned turn off completely, but the status LEDs for the load switch are unaffected.

bandtank, 2018-11-16:
LEDs on these nets likely won't work long term. I didn't think about it before, but you'll probably need to drive the LEDs with another pin. You could also use comparators to drive the LEDs after calculating the expected voltages on either side of the level shifters, but that's a lot of work for no real gain. You can't pull any of the resistors out or the level shifter will stop working.

GlenNicholls, 2018-11-17:
Hmmm, good to know, I guess it is a good thing this isn't critical, although it will be annoying for the user. Is there a way to make this work with the level shifters?

bandtank, 2018-11-17:
I gave it some thought for a minute or two this morning and I didn’t come up with an obvious solution. Part of the problem is speed. If the net needs to be fast, it would be a bad idea to drive an LED without a buffer in series. There may be a more elegant solution, but using a comparator would work. You’d need to know the voltage levels in every condition: driving high and low from one side and then the other. At that point, pick a side and set the reference.

GlenNicholls, 2018-11-19:
we do have two free pins on the tiny, so I think that is the cleanest solution. @graemeDnf once the PCB is updated, feel free to close this

bandtank, 2018-11-19:
I typically put LEDs on a shift register. Even if you don’t want to use SPI, you can clock a shift register manually to get 8+ LEDs with only two pins. Just an idea.

Get Outlook for iOS<https://aka.ms/o0ukef>

________________________________
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

graemeDnf, 2018-11-29:
Moved relevant LEDs from level shifter lines to free GPIO pins (BCM 0 and BCM15)

Closed 2018-11-29.

Thread 70 (2018-11-16):

[PCB] LED 2 silkscreen shows wrong orientation

GlenNicholls, 2018-11-16:
LED2 orientation in the slikscreen is backward, the dot should be facing the other direction.

graemeDnf, 2018-11-29:
fixed

Closed 2018-11-29.

Thread 71 (2018-11-16):

[PISW] ADC object not callable in runner/main.py

GlenNicholls, 2018-11-16:
When instantiating the adc in main.py like so:

https://github.com/GlenNicholls/solar_tracking_project/blob/a6b06f27422e76f25a4b74cffd05f2398193b8c8/runner/main.py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

https://github.com/GlenNicholls/solar_tracking_project/blob/a6b06f27422e76f25a4b74cffd05f2398193b8c8/runner/main.py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

It only fails here:

https://github.com/GlenNicholls/solar_tracking_project/blob/a6b06f27422e76f25a4b74cffd05f2398193b8c8/runner/main.py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

but works fine for the previous instantiation:

https://github.com/GlenNicholls/solar_tracking_project/blob/a6b06f27422e76f25a4b74cffd05f2398193b8c8/runner/main.py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

https://github.com/GlenNicholls/solar_tracking_project/blob/a6b06f27422e76f25a4b74cffd05f2398193b8c8/runner/main.py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

This is the log:

    pi@raspberry:~/solar_tracking_project $ sudo python runner/main.py
    2018-11-15 20:34:00,636 - main_app.rtc - INFO - creating an instance of the rtc
    2018-11-15 20:34:00,639 - main_app.sys_mon - INFO - creating an instance of the sys_mon
    <Adafruit_MCP3008.MCP3008.MCP3008 object at 0xb5c0db30>
    2018-11-15 20:34:00,651 - main_app.panel_power - INFO - creating an instance of the panel_power
    2018-11-15 20:34:00,656 - main_app.battery_power - INFO - creating an instance of the battery_power
    Traceback (most recent call last):
      File "runner/main.py", line 166, in <module>
        adc_object             = adc
    TypeError: 'module' object is not callable

I have dug around a bit and after checking this in the sun_sensor package, I do not see the same issues.

GlenNicholls, 2018-11-16:
fixed per  77ba9a3

Closed 2018-11-16.

Thread 72 (2018-11-16):

[PCB] Add missing connections for motor control

GlenNicholls, 2018-11-16:
Missing motor control connections for the PCB need to be added to the CSV following the format that I have defined.

https://github.com/GlenNicholls/solar_tracking_project/blob/414cd067f740381de8ed945e593da0e2582edce6/runner/gpio.csv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

Thread 74 (2018-11-16):

[PISW] Add dataframe class

GlenNicholls, 2018-11-16:
Per our discussion today, work on a class for setting up a dataframe. Reference .runner/ for main.py where it will live, .test/ for dataframe tests, and .src/ for where all application packages live.

Columns that would be needed:
* time
* latitude/longitude
* azimuth/elevation initial count value
* panel and battery voltage, current, power, energy?

Will add others as I think of them

GlenNicholls, 2018-11-26:
Closing per  2031667

Closed 2018-11-26.

Thread 78 (2018-11-19):

[PISW] Add limit switch INTs to halt motors in stepper motor class

GlenNicholls, 2018-11-19:
Adding pins like so:

https://github.com/GlenNicholls/solar_tracking_project/blob/8eca18658b97e4545bd6755c86a6eb138e5fe64d/src/motor_control/stepper_motor.py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

configure these as interrupts and ensure they immediately halt motors during an event. The motors should then move in the opposite direction some fixed amount to determine start position

GlenNicholls, 2018-11-29:
closed per most recent commit

Closed 2018-11-29.

Thread 79 (2018-11-19):

[SYS] Pi date and time do not update automatically on school network

GlenNicholls, 2018-11-19:
The date and time on the pi have not been updating automatically like they should, but I have only tested this on the school network. At home, I have not experienced this, but I also haven't been using VNC to develop on the device. Hopefully, this is unique to the school network so we don't have to figure out how to get the time since trying to use raspi-config didn't work and we had to set the time manually.

GlenNicholls, 2018-11-30:
ad43eab

Closed 2018-11-30.

Thread 80 (2018-11-19):

[PISW] Add lock error checking in open loop tracking mode

GlenNicholls, 2018-11-19:
In below function, add error checking for lock logic on both az/el. Should also add a counter so we don't get stuck here. On failure, an error should be logged with some extra information.

https://github.com/GlenNicholls/solar_tracking_project/blob/64155a29d0000d75d8f84c92314c2505538193bb/runner/main.py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

GlenNicholls, 2018-11-19:
We also need to figure out how to integrate the limit switch logic somewhere in here as well. I'm not too sure how this should work with the encoders yet, but there are a few cases I want to discuss:
* when encoder reads min/max count on either az/el
* if encoder thresh has not been met when limit switch is asserted

GlenNicholls, 2018-11-20:
closed per 2c058d3

Closed 2018-11-20.

Thread 83 (2018-11-29):

[PISW] Add user error for sim menu

GlenNicholls, 2018-11-29:
Add a way to induce user desired error in the simulation tracking menu to further demonstrate the shaft encoders.

GlenNicholls, 2018-12-08:
This isn't useful beyond demonstration and maybe during test. I am closing this for now.

Closed 2018-12-08.

Thread 85 (2018-11-29):

[PISW] Add error checking for calibration so system doesn't get stuck when motors don't move

GlenNicholls, 2018-11-29:
Currently, if the motors don't move, the system gets stuck in an infinite loop. Add some error checking so it doesn't get stuck and log the critical error for the user

Thread 86 (2018-11-29):

[PISW] Add limits to how much sun sensor can adjust system

GlenNicholls, 2018-11-29:
For cloudy days and such, the sun sensors should not be able to move the mount further than some amount so it doesn't go completely off course if there is a bright spot somewhere else in the sky. The shaft encoders will fix this, but POWER!!!

GlenNicholls, 2018-12-03:
It has been proven that the shaft encoders do fix this, but only on the next update cycle.

Closed 2018-12-05.

Thread 87 (2018-11-30):

[PCB] Move pi hat USB header so lip of physical hardware is over the edge of the board

GlenNicholls, 2018-11-30:
As the title states, this needs to be moved closer to the edge so the lip of the USB header is hanging off the edge of the board. Currently, the lip elevates the connector slightly. Maybe not a priority, but marking this bug so we don't lose track of the issue for the "customer".

Thread 88 (2018-11-30):

[PISW] Add support for full RTC timekeeping

GlenNicholls, 2018-11-30:
I have done the research, and it is possible to handle timekeeping of the pi using dtoverlay so that we do not need to have internet access all the time (thus the class for system parameters like wifi). There needs to be careful consideration with who has control. If we try to access RTC via I2C manually while the system has control with dtoverlay, there could be issues (I don't know what those are). However, we can set this control up via this question on the pi forums:

https://www.raspberrypi.org/forums/viewtopic.php?t=224235

I don't think I will have time to carefully implement this control, but it is documented here now as an enhancement... YOU'RE WELCOME TONY

Thread 92 (2018-11-30):

[SYS] Add config steps to README

GlenNicholls, 2018-11-30:
Add steps from following to README.

https://raspberrypi.stackexchange.com/questions/73166/raspberry-pi-zero-w-cant-connect-to-wifi-through-desktop-environment

I don't remember having to do this the first time, but the SD card I had to use from Mike didn't have the newest OS on it nor did it have access to internet to update.

GlenNicholls, 2018-11-30:
Not an issue with new raspbian OS

Thread 93 (2018-11-30):

[PISW] Test fails when doing fresh OS install with all software

GlenNicholls, 2018-11-30:
I am seeing this error when I try to run the test. i did a fresh os install and installed all software per the README

    pi@raspberrypi:~/solar_tracking_project $ sudo python setup.py test
    running pytest
    running egg_info
    writing requirements to src/pv_array_solar_tracker.egg-info/requires.txt
    writing src/pv_array_solar_tracker.egg-info/PKG-INFO
    writing top-level names to src/pv_array_solar_tracker.egg-info/top_level.txt
    writing dependency_links to src/pv_array_solar_tracker.egg-info/dependency_links.txt
    reading manifest file 'src/pv_array_solar_tracker.egg-info/SOURCES.txt'
    writing manifest file 'src/pv_array_solar_tracker.egg-info/SOURCES.txt'
    running build_ext
    Traceback (most recent call last):
      File "setup.py", line 64, in <module>
        package_data      = {'':['__init__.py']} # ['' : ['*.data', '*.rst'],] -- include packages with these file
    delimeters in all sub dirs from package_dir
      File "/usr/lib/python2.7/distutils/core.py", line 151, in setup
        dist.run_commands()
      File "/usr/lib/python2.7/distutils/dist.py", line 953, in run_commands
        self.run_command(cmd)
      File "/usr/lib/python2.7/distutils/dist.py", line 972, in run_command
        cmd_obj.run()
      File "build/bdist.linux-armv6l/egg/ptr.py", line 176, in run
      File "build/bdist.linux-armv6l/egg/ptr.py", line 187, in run_tests
      File "/usr/lib/python2.7/dist-packages/pytest.py", line 21, in <module>
        from _pytest.config import (
    ImportError: cannot import name _preloadplugins

Thread 94 (2018-11-30):

[PCB] Make unique connectors for all external interfaces...

GlenNicholls, 2018-11-30:
Based on today's short "incident", I am making a bug about the headers that we have currently. First, lets move that ground connection away from the high voltage connections... Next, I think it is a good idea to make sure all the headers for Mike's board and panel/battery can only be plugged into a specific header one way. In hindsight, we should've known better, but you live and you learn 👎

Thread 95 (2018-12-01):

ADC ch 2 curr. amp has intermittent gnd

graemeDnf, 2018-12-01:
The amplifier feeding into ADC channel 2 seems to have a spotty ground connection. It should be bluewired to the ground bus
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

GlenNicholls, 2018-12-03:
I discussed this with Mike and we decided that this isn't critical for us to fix right now. I am not going to be fixing this so that I can focus on other outstanding tasks for our pres, sw flow charts, etc.

graemeDnf, 2018-12-03:
I see how it is. My issues aren't important to you . . .

bandtank, 2018-12-03:
No matter what Glen says, you're important to me, Graeme.

GlenNicholls, 2018-12-05:
ditto

Thread 97 (2018-12-05):

[PISW] Limit sw ints cause mount to overshoot if it misses edge of next interrupt

GlenNicholls, 2018-12-05:

Closed 2018-12-05.

Thread 99 (2018-12-05):

[PISW] Bug in next position calculation for open loop menu

GlenNicholls, 2018-12-05:
The calculation for the next position below is incorrect. Update this to provide system with correct calculation for how far to move motors. In the lab, this update is incorrect and causes the motor to move to correct position and then immediately move back the difference.

https://github.com/GlenNicholls/solar_tracking_project/blob/4b9a3cfcd25955af6ff08a980abac3c126868e61/runner/main.py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

GlenNicholls, 2018-12-07:
I believe this "bug" was the initial indicator for #102. After fixing the calibration logic issue, I have tested this menu and I am not seeing the same issue where the mount moves the wrong direction when starting from the initial position after startup calibration.

The reason this occurred is that the limit switch pins for az/el we're swapped, so software interrupt noticed it reached the limit for az and moved the mount the opposite direction until it saw that the limit switch was no longer in the wrong region. However, it never saw this state change due to the pins being swapped, so it continued moving until azimuth hit the hard limit switch, cutting power to the motors.

I'm surprised we never saw this behavior on elevation, but I *think* this is fixed.

Thread 102 (2018-12-07):

[PISW] Thank god I caught this

GlenNicholls, 2018-12-07:
This calibration function should be revised. It works as is right now, but it should use interrupts like before. Make sure that az/el are isolated so the state of one doesn't influence the other.

https://github.com/GlenNicholls/solar_tracking_project/blob/d01d46178745f1d25ad69ea53f6527f5529b52ae/src/motor_control/stepper_motor.py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

GlenNicholls, 2018-12-07:
NOTE: The interrupts are currently disabled for the debugging on tracing this issue earlier. They need to be re-enabled for the system to recognize when it reaches the limit switch limits. Currently, the software will be unable to detect the az/El limits outside of calibration. I will not be touching the code before tomorrow, so I am logging this here so it doesn't slip through the cracks.

bandtank, 2018-12-07:
When you make temporary changes, put TODO in a nearby comment.

Then run this every so often to make sure you aren’t forgetting anything:

grep -ri todo *

Also, do not commit temporary changes. Use this to commit pieces of files so you can leave the temporary change in the working copy instead of the staged or committed copy:

git add -p [files]

Never commit a temporary change without some form of tracking - todo comments, partial commits, tasks/issues, etc.

GlenNicholls, 2018-12-07:
I see, thanks for the suggestions, I'll keep those in mind moving forward.

On campus, it's hard because it isn't possible to scp wirelessly, so the easiest way to develop there has been to push/pull, but I hate doing that because it just clutters the commits with debug code. Is there a better way to work between systems using the -p flag or something similar?

bandtank, 2018-12-07:
If you absolutely have to commit, use one of the other two methods to track
the temporary code and put it in a branch that is known to have bad code.
Then you can leave it out of a merge into master. I would avoid this at all
costs, though, because once it's in the repo it will eventually be used
incorrectly, unknowingly, or both.

On Thu, Dec 6, 2018 at 10:05 PM GlenNicholls <notifications@github.com>
wrote:

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

bandtank, 2018-12-07:
Another option is to build debug hooks into the code.

```
if debug:
  #do stuff
else:
  #do other stuff
```

It's still not ideal, but it's much, much safer.

Thread 104 (2018-12-08):

[PCB!!!!!!!!!] Graeme, this is fucking urgent!!!!!

GlenNicholls, 2018-12-08:
You're playing chubby bunny with shitty ideas.

GlenNicholls, 2018-12-08:
@graemeDnf I just want to thank you for actually responding to my issues...

graemeDnf, 2018-12-09:
You open so many of them, it's hard to keep track sometimes. Glad I could do that for you...

bandtank, 2018-12-09:
lol. FYI - you can do this in the issue search box to find the issues assigned to a specific person:

`is:open assignee:bandtank`

It helps if you want to find your todo list when the tasks aren't included in milestones and if they don't have labels.

Closed 2018-12-18.
