GlenNicholls/solar_tracking_project/docs/pi_hat/pi_hat_schematic.pdf

+5V

+5V

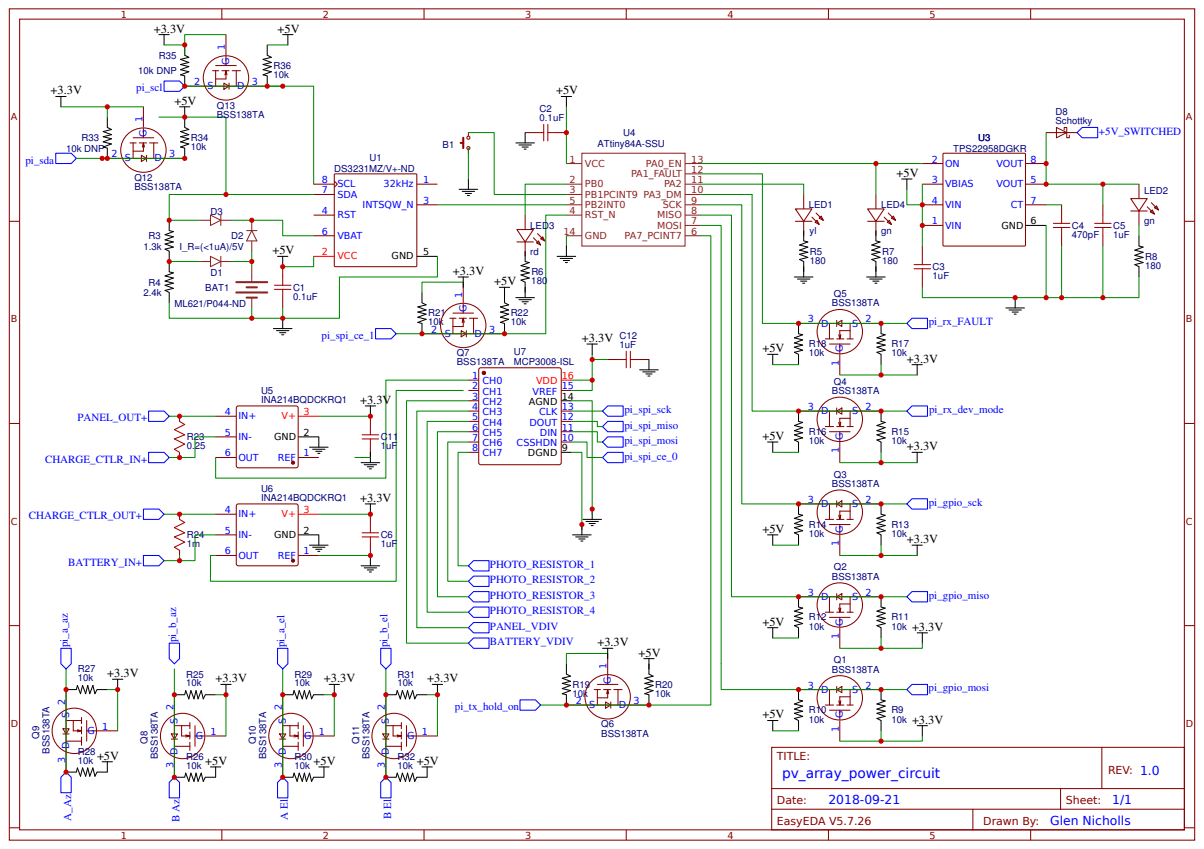
[picture p4: page 1]
