GlenNicholls/solar_tracking_project/(list of files, drawings)

Other design files:
hardware/pi_hat/SolarTrack1.pcb
