GlenNicholls/solar_tracking_project/test/dev_power_measurement.py

#!/usr/bin/python

from test_mcp3008 import *
from test_power_measurement import *
import time

# adc test
test_adc_read()

# power test
test_panel_current()
test_panel_voltage()
test_panel_power()

test_battery_current()
test_battery_voltage()
test_battery_power()
