GlenNicholls/solar_tracking_project/(commit log)

2018-03-24 - Added .gitignore - Rough start on test controller hardware design example (see Glen for details). Basically, a controller that activates light sources around a solar panel to test the tracking syst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
    [test_controller.brd, test_controller.sch]
2018-07-31 doc commits for boards as well as src code for sw I forgot about. contains old arduino test code, pi scripts, and outlines for working samg53 projects. Newest integration code to come once bugs are w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
    [main.c]
2018-07-31 updated timing constraint for clock-to-out timing failure
    [main.c]
2018-09-03 added source code for reading current sensor, logging data from current sensor, and lib for interfacing with the ADA254
2018-09-03 made updates to both SD logging library and arduino sketch for testing with current sensor
2018-09-04 added README for UART as test script for loopback
2018-09-05 uploaded test code for communicating uart via gpio b/t arduino and pi
2018-09-14 added doc for possible comp and SW for current sensor and ADC
2018-09-14 update bug fix and branching so Tony won't call me Hitler
    [ACS712.py]
2018-09-14 syntax issue because F IDEs
    [ACS712.py]
2018-09-14 debugged changes, will be adding fancy directory printer :)
2018-09-15 made some updates to ACS712 device lib
2018-09-15 updates for ACS712 package to fix some minor issues, next will be working on a DS3231 package along with high-level status/ctrl, logging, database, voltage sensor, etc.
    [ACS712.py]
2018-09-20 Adding shaft encoder counting driver (untested)
2018-09-21 added docs for circuitry
2018-09-22 added datasheet for 555 and the power circuit schematic
2018-09-23 Upload DesignSpark schematic v1
    [mainBoard.sch]
2018-09-24 added current power circuit bom and changed dir name
    [Bom_7657102.csv]
2018-09-24 Fixed issues with schematic and uploaded pcb
    [SolarTrack1.pcb, mainBoard.sch]
2018-09-24 Added LEDs to PCB and update schematic
    [SolarTrack1.pcb]
2018-10-04 Fixed compile bugs in shaft encoder code
    [counting.py]
2018-10-05 added system diagram along with src documentation for shield power circuit.
2018-10-07 Adding update to setup.py to see if CircuitPython code will work in our application. Not too sure how itll go with the RTC, but hoping it will work
2018-10-07 testing DS3231 from circuit python
2018-10-07 progress to DS3231 package and added todo items for missing functionality we need
    [DS3231.py]
2018-10-07 updates to DS3231 to fix bugs and improve cmd line logging. Still need to add support for setting alarms
    [DS3231.py]
2018-10-08 committed mikes code for az/el calculations for open-loop tracking
2018-10-10 moved arduino sketch to misc_dev
2018-10-11 FINALLY got the fucking shaft encoders working
2018-10-11 cleaned up docs
    [Bom_7657102.csv, SolarTrack1.pcb, mainBoard.sch]
2018-10-11 cleaned up more and added compile output for AVR
    [Bom_7657102.csv]
2018-10-13 testing to see if test framework will work now
2018-10-13 Got test suite up and running with first test. Need to now re-factor current tests to fit this format
2018-10-13 updating test routine for current sensor. Added todos for refactoring
2018-10-13 updates to testing for current sensor
2018-10-14 updated test to ensure temp will cause failure during integration testing
    [test_ds3231.py]
2018-10-14 forgot to add ADC datasheet
2018-10-14 updated pi_hat circuit. It does not have level-shifters as Graeme has worked this
2018-10-14 changed some dir names and moved pi_hat hw docs to hardware
    [Bom_7657102.csv, SolarTrack1.pcb, mainBoard.sch]
2018-10-14 cleaned up some old stuff we no longer need. Started main software app for the uC, will now be branching
    [main.c]
2018-10-14 updated schematic and updates to pi hat sw
2018-10-14 finalized schematic to push to master
2018-10-14 updated sw and schematic for graeme
2018-10-14 committing blinky ex with interrupts to test
2018-10-15 Got interrupts and sleeping working for uC. Added delay to test interrupts aswell for DS3231 test
2018-10-15 updated shield pcb
    [SolarTrack1.pcb]
2018-10-15 update for debugging as LED wont retain state. Seeing if this is fault of INT0
2018-10-15 committing code that works for simple test with interrupts.
2018-10-16 updated power ctrl stuff to ensure it works
2018-10-17 updating power ctrl software
2018-10-19 something is broken and I cant figure it out
    [pi_hat_ctrl.h]
2018-10-19 traced down bug... Tony was right about abstracting the low level names lol
    [pi_hat_ctrl.h]
2018-10-19 More PCB updates
    [SolarTrack1.pcb]
2018-10-19 updated readme and apparently nothing works for uc. Im not sure how to check pin status without function
2018-10-19 JESUS GO AWAY FINALLY OMG. 5 COMMITS TO FIGURE OUT HOW TO REMOVE SOMETHING THAT DOESNT EVEN EXIST BECAUSE APPARENTLY MOVING Hardware/* to hardware/ WAS THE WORST DECISION OF MY LIFE
    [test_controller.brd, test_controller.sch]
2018-10-20 fixed all broken stuff
    [pi_hat_ctrl.h]
2018-10-20 PI GPIO peripheral pinout
    [GPIO_Pinout.xlsx]
2018-10-20 Added motor control section
    [GPIO_Pinout.xlsx]
2018-10-20 too tired to write anything
2018-10-20 continued progress to timer isr and stuff
2018-10-21 pushing this to master so Brad can see comments. DONT USE YET CUZ BROKEN
    [main.py]
2018-10-21 got timer working and tested. Need to use scope to verify that bounce is not showing up internally
2018-10-21 okay, timer is working, but disabling it is not. No wonder this program got all wonky when trying to enable/disable interrupts inside the main func. Working now on figuring out why the stopDebounceTi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
2018-10-21 final (?) shield PCB
    [SolarTrack1.pcb]
2018-10-21 removed old test code that is no longer needed
    [main.c]
2018-10-21 todo for pcb
2018-10-21 had wrong value being shifted into reg, timer now turns off :)
    [pi_hat_ctrl.h]
2018-10-21 Final PCB v2
    [SolarTrack.pcb]
2018-10-21 Correct pcb file this time
    [SolarTrack1.pcb]
2018-10-22 updated schematic, will be synchronizing Graemes stuff in here at some point. Will also include final bom
    [Bom_7657102.csv, bom_2018_10_19T213238.xlsx, ~SolarTrack1.pcb]
2018-10-22 progress to setting up logic for 16 bit timer
2018-10-22 taking a break to think through how 16-bit timer will work since it needs to monitor a few things
2018-10-22 added use of some macros to simplify code. Also started to fill out func for low power
2018-10-23 dont use, everything broke. dont worry
    [attiny84.h, main.c, pi_hat_ctrl.h]
2018-10-23 loop_until_* is broken, so wont be using it
    [attiny84.h, main.c, pi_hat_ctrl.h]
2018-10-24 broke clocks and figured out how to fix... this is no longer an issue
    [attiny84.h, main.c, pi_hat_ctrl.h]
2018-10-24 had to add cycle for interrupts to work. Not sure that this will matter with sleep enabled, but this fixed the issues
    [attiny84.h, main.c]
2018-10-24 so sleep is not working, will have to look into this after everything else is working
    [main.c]
2018-10-24 using IDLE works fine, but power down and stand by dont work, so im probably doing something wrong
    [attiny84.h, main.c]
2018-10-24 got timer 1 sort of working, still cant get it working with ctc though
2018-10-24 Think the logic is mostly worked out. Now need to debug timer and do code review
2018-10-25 made some slight changes for the 16-bit timer
2018-10-26 almost forgot to push long delayed version of timer
2018-10-26 playing with sleep config. Some ordering is off and the processor doesnt generate the level int0 I think due to disabling interrupts.
2018-10-26 Small changes for first successful motor test
2018-10-26 Added shaft encoder code to main.py
2018-10-26 Updated encoder class implementation (untested)
2018-10-28 updated readme, test, and now working through uc bugs
    [main.c, test_ds3231.py]
2018-10-29 updated schematic with bugs noted
2018-10-30 Added voltage measurement dividers to pcb
    [SolarTrack1.pcb]
2018-10-30 removed disabling of timers after getting sleep to work cuz it is pointless in power down mode my guy
2018-10-30 Fixed attiny connection issue
    [SolarTrack1.pcb]
2018-11-01 Resolved routing issues
    [SolarTrack1.pcb]
2018-11-02 Created stepper_motor class and updated comments in stepper_ctrl_2
2018-11-02 Corrected syntax errors in stepper_motor.py
    [stepper_motor.py]
2018-11-02 Added import of stepper_motor.py
2018-11-02 Rename class_counting to encoder, updated __init__, added import to main.py
2018-11-02 Fixed indentation in encoder.py
    [encoder.py]
2018-11-02 Fixed indentation in encoder.py take 2
    [encoder.py]
2018-11-02 Added calls to move motors in main.py
2018-11-02 added updated current sensor datasheet. Started new packages for breaking out ACS712 package. Not sure if we want to keep current_sensor package, but there is a placeholder for now
2018-11-02 Hard coded az and el in main.py for testing, need to refactor once testing is complete
2018-11-02 fixed bug in ds3231 test and made some additions to main routine
    [main.py, test_ds3231.py]
2018-11-02 Made some changes to main.py and encoder.py for testing
2018-11-02 updates to power measurement package
2018-11-03 Additional PCB fixes
    [SolarTrack1.pcb]
2018-11-04 Fixed more pcb issues
    [SolarTrack1.pcb]
2018-11-04 better usb connector
    [SolarTrack1.pcb]
2018-11-05 updated power measurement class
2018-11-05 added two test cases for power measurements, will just be quickly verifying the adc before expanding the current sensor
2018-11-05 removed possible class and added dev mode to debug adc verification
2018-11-05 updated to BCM pin numbering and removed #!/usr/bin/python since it was causing pi networking to hang when this was not called from the command line
2018-11-05 created test helper class to avoid copying and pasting so much code. Also expanded power measurement class so brad can just pull this in easier
2018-11-05 added final test cases for power measurement
2018-11-06 LED size/power headers
    [SolarTrack1.pcb]
2018-11-06 updated power measurement class and tests
2018-11-06 updated test case for system monitor
2018-11-06 deleted unused files, added hw for mike, and updated voltage read eqn for adc
2018-11-07 started sun sensor translation for Brad
2018-11-08 finalized everything in sun sensor logic package for main.... I dont test because im BA
2018-11-08 updated test utils to remove logging init since not sure that this will work. Added test cases for sun sensor code
2018-11-09 updated test utils to use logger. Debugged most of sun sensor package logic
2018-11-09 standardized sys mon test and updated sys mon for error checking
    [sun_sensor.py, test_sun_sensor.py, test_sys_mon.py]
2018-11-09 removed mcp specific dir as we encapsulate this test in power measurements. Also refactored tests to use test_utils
2018-11-09 missed updated logger in ds3231 test
    [test_ds3231.py]
2018-11-09 added logging capability for shaft encoder package
2018-11-11 added future to encoder so div will automatically convert to float. also adding more logic to main
2018-11-12 added manual fault clearing for holding button for 3s
2018-11-12 updated current eqn to align with correct conversion
2018-11-12 updated shaft encoder to pass initial count. Made some slight adjustments to main
2018-11-13 removed hw config in encoder class
2018-11-14 small syntax changes in main and se. Updated stepper motor class
2018-11-15 added enum for motor control and started incorporating Mikes stuff to main, will be working on SE next
2018-11-16 syntax error for class
    [utils.py]
2018-11-16 recovered deleted file :/ hopefully this wasnt set back too much due to the gitignore =(((
    [pi_hat_ctrl.h]
2018-11-16 changed debounce timer and added datasheet
2018-11-16 adding pinout file for parser
    [gpio.csv]
2018-11-16 added original file parsing code to utils and test script for figuring out how this should be done
    [gpio.csv]
2018-11-16 updates to gpio for mikes pinout, main, and added brads old sw so we make sure we dont regress
    [gpio.csv]
2018-11-16 bug in gpio
    [gpio.csv]
2018-11-16 update for missing class in init
    [main.py]
2018-11-16 lets see what is wrong here
    [encoder.py]
2018-11-16 nothing changed and the el/az swapped. OH NOOO ITS SOFTWARE. bitch, no its not, its josh and brad cuz there not here
    [main.py]
2018-11-17 updated parser test and still deciding how it should generate key/val
    [gpio.csv]
2018-11-18 updating sun sensor algorithm to make more sense orientation wise. These changes will also simplify the operation a bit
2018-11-18 more changes to sun sensor
2018-11-18 finalized initial change for sun sensor. Will now be updating test and working out syntax issues before moving to integrating in main
    [sun_sensor.py]
2018-11-18 updated test and sensor logic, will be debugging now
2018-11-18 syntax issues and cant scp files to test wirelessly on campus
    [test_sun_sensor.py]
2018-11-18 missing function parameter in el dir
    [sun_sensor.py]
2018-11-18 more test syntax errors
    [test_sun_sensor.py]
2018-11-18 seeing weird behavior with az saying it is moving north... which it cant and sw shouldnt do this. making motor enum unique to see if it fixes this and decoding in mot move routine
    [stepper_motor.py]
2018-11-19 moved parser to tmp/ and also commented out parsing class in utils per closed issue
    [utils.py]
2018-11-19 updates to main and starting to add limit switch compatability in stepper motor class
2018-11-19 updates to main. Starting to incorporate encoders in open loop routine
2018-11-19 adding more logic for encoder logic in open loop
2018-11-19 cleaned up some syntax issues and added cleanup for GPIO. Might need to revisit cleanup() TODO
    [main.py]
2018-11-19 added limit switch logic to motor control and update to sun sensor
2018-11-19 syntax errors in main app, readability, and motor control
    [main.py, stepper_motor.py]
2018-11-19 added SE method to set counter for calibration and updated open loop tracking in main
2018-11-20 added manual override for tracking since user would need to know current az/el during manual control
2018-11-20 added new menu for config of lat/long global that wasnt working and fixed some minor bugs
    [main.py]
2018-11-20 fixing bug for move menu
    [main.py]
2018-11-20 hardware bug fixed with software for PCB wiring on encoder pins a and b for az/el
    [gpio.csv]
2018-11-20 added abs to degree value since dir takes care of it. Also updated gpio.csv for hw bug
    [gpio.csv]
2018-11-20 updates to tracking loop to reduce iterations before failure
    [main.py]
2018-11-20 debugging to figure out why el locks up
2018-11-20 committing tiny code since power keeps getting cut
2018-11-23 added cal routine for main and also added deg set for encoder for cal
2018-11-23 updated init deg for encoders during cal
2018-11-27 updating calibration menu
2018-11-27 updated led pins for bluewiring
2018-11-27 moving calibration to main
2018-11-29 fixed el not calibrating bug
    [main.py]
2018-11-29 updated set menus to print curr positions for user
2018-11-29 updated bug in limit switch interrupt
    [main.py, stepper_motor.py]
2018-11-29 fixing bugs with moving too far
    [main.py]
2018-11-29 updating bug induced by using .lower on non string like num
    [main.py]
2018-11-29 More PCB fixes
    [SolarTrack1.pcb]
2018-11-29 removed unnecessary pcb files
    [SolarTrack.pcb, mainBoard.sch]
2018-11-30 Issue #84 and #79
    [main.py]
2018-11-30 added error checking for calibration routines for #85
    [main.py]
2018-11-30 added power measurement menu
2018-11-30 added todo for issue
    [main.py]
2018-11-30 fixed bug in test arg and added menus for testing easily without console menu
    [main.py]
2018-11-30 changing motor movement for cal
2018-11-30 fixed set pos bug
    [main.py]
2018-11-30 cleared cleanup for the init since it breaks adc package
2018-11-30 fixed bug in sun sim where pos was moving tot of x deg instead of moving panel to desired pos
    [main.py]
2018-11-30 bug fix in utils
    [utils.py]
2018-11-30 bug fix in main
    [main.py]
2018-11-30 Added previous and current encoder columns to dr_cols
2018-12-01 bypassed shaft encoder to update position
2018-12-01 undo of bypass of shaft encoders from last commit
2018-12-03 added calibration script for calling the thing
2018-12-03 Moved LEDs/Cleaned up level shifters
2018-12-03 fixed status LED connections
    [SolarTrack1.pcb]
2018-12-06 updated software flow charts per #77
2018-12-07 using round and then typecasting to int for steps in motor
2018-12-07 debug in encoder
2018-12-07 update to lim sensor
2018-12-09 Shaft Encoder Datasheet
2018-12-11 renamed dirs in docs/ and added sun_sensor files
    [GPIO_Pinout.xlsx, final_v1.dwg, final_v2.stl]
2018-12-11 updated GPIO for Mikes motor control section
    [GPIO_Pinout.xlsx]
